kristjem/hagiwo-sh-101/(threads)

Thread 1 (2025-01-10):

CV Out 1, no pitch

kristjem, 2025-01-10:
It seems this diode should be mounted the other way around. It should allow flow from ground to "output".

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

kristjem, 2025-01-10:
Diode is switched around. Not tested yet.

kristjem, 2025-01-11:
Modul testet. After switching the diode around, pitch is working on CV 1! Schematics is also updated to reflect the change of diode orientation.

Closed 2025-01-11.

Thread 2 (2025-01-10):

Impossible to get a stable CV tuning

kristjem, 2025-01-10:
The single turn trim pots should be replaced with multi turn 5K trim pots.
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

Also, the software needs to be calibrated by trial and error, namely by altering:

```
float AD_CH1_calb = 1.085;//reduce resistance error
float AD_CH2_calb = 1.094;//reduce resistance error

```
try to modify the value in the range of 0.8~1.2 or so. Around 0.9 seems to be close for CV out 2, but have not tested this with multi turn trim pots.

kristjem, 2025-01-10:
Trim pots replaced, not tested yet.

kristjem, 2025-01-14:
Replacing the trim pots to multi turn 5K trim pots definitly helped, but also a lot of trial and error to set the float AD_CH1_calb correctly. For me it seems to be around 1.15.

The main problem was noise making the ADC readings and therefore the quantization and volt outputs all over the place. It is still not perfect, but usable.

Closed 2025-01-14.

Thread 3 (2025-01-11):

Schematics has 2 caps with wrong value

kristjem, 2025-01-11:
These should be 1 uF, not 10 nF:
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

Hagiwo's schematics
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

Update the strip board schematics

kristjem, 2025-01-11:
Strip board schematics updated!

Closed 2025-01-11.

Thread 4 (2025-01-11):

False selections when turning the encoder

kristjem, 2025-01-11:
Sometimes when rotating the encoder to move up/down the menu, selections are registered, as if I clicked the encoder. For example when moving past the `DIV` menu item, `DIV` might go from `1` to `2` without me clicking the encoder. It always seems to be just one false selection before the encoder is "releaset" and able to travel down or up the menu again.

There might be some noise that needs to be eliminated.

kristjem, 2025-01-14:
Solved in firmware_v2. See README.md

kristjem, 2025-01-18:
Threshold finally set to 100 for the `debounceDelay` variable

Closed 2025-01-14.

Thread 5 (2025-01-14):

C0 (0V) is not in tune

kristjem, 2025-01-14:
Seems like 0v is quantized noise, which gives an off tune sound

kristjem, 2025-01-14:
The calibration factor for CV input needs to be adjusted as well. It's still not tracking correctly between octaves

kristjem, 2025-01-18:
This was fixed by setting a threshold of 65 on the `readAverageADC` function (it then returns 0, since it should produce 0V)

Closed 2025-01-18.

Thread 6 (2025-01-19):

Noise makes qantized input wrong

kristjem, 2025-01-19:
In the setup, run average read on the CV input (0V) and store that as a noise variable. Then subtract that noise variable from all future readings
