kristjem/hagiwo-sh-101/(commit log)

2024-12-31 fix encoder rotation noise false selections firmware.ino
    When the encoder is turned right or left, the menu item is increased by one, even though the encoder push button is not clicked. For example if i rotate the encoder past the division menu, division is increased by one, for example from 1 to 2. Or if i rotate the encoder past the play menu, it turns into rec before letting me continue to navigate further down the menu. It does this to every single menu item; it increases (toggles) that menu item with one before continuing to the next menu item.
    With the help of Github Copilot:
    The issue was caused by the encoder's push button being read incorrectly or noise in the encoder signals, w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
    [firmware.ino]
2025-01-11 Add Strip board schematics file
    Requires [DIY Lyout Creator](https://github.com/bancika/diy-layout-creator/releases)
2025-01-11 Add strip borad schematics image v1.1.0
2025-01-13 Fix software calibration CV recording
    [firmware_encoder_fix.ino, firmware_v2.ino]
2025-01-14 Fix encoder false selections
    [firmware_v2.ino]
2025-01-18 Fix noise at 0V input
    [firmware_v2.ino]
2025-01-18 Fix debounce encoder problem
    [firmware_v2.ino]
2025-01-25 Create README_circle_seq.md
    I've been struggling with the original firmware; I never managed to get the recorded CV in tune when it was output. I therefore wanted to try and make the sequencer work somehow, without the need to input cv to make it playable. I first think it should do bass lines, but later I plan on implementing arpeggios also. May be sample and hold or LFO
2025-01-25 Fix encoder and menu issues
    [firmware_circle_seq_v1.ino]
2025-01-25 Fix Division not being used, CV and Gate output to both DACs
    [firmware_circle_seq_v1.ino, main.ino]
2025-01-25 Fix pattern array to note conversion
    [firmware_circle_seq_v1.ino]
2025-01-25 Fix display current step
    [firmware_circle_seq_v1.ino]
2025-01-25 Fix pattern text overflow on display
    [firmware_circle_seq_v1.ino]
2025-11-08 Fix encoder
2025-11-08 Fix encoder2
2025-11-08 Refactor encoder
    Refactor and enhance the Bassline Key Sequencer code, improving encoder handling, UI updates, and overall structure.
2025-11-08 Refactor encoder, README
